NUSGreyhats/hackbadge/art/hackbash.png

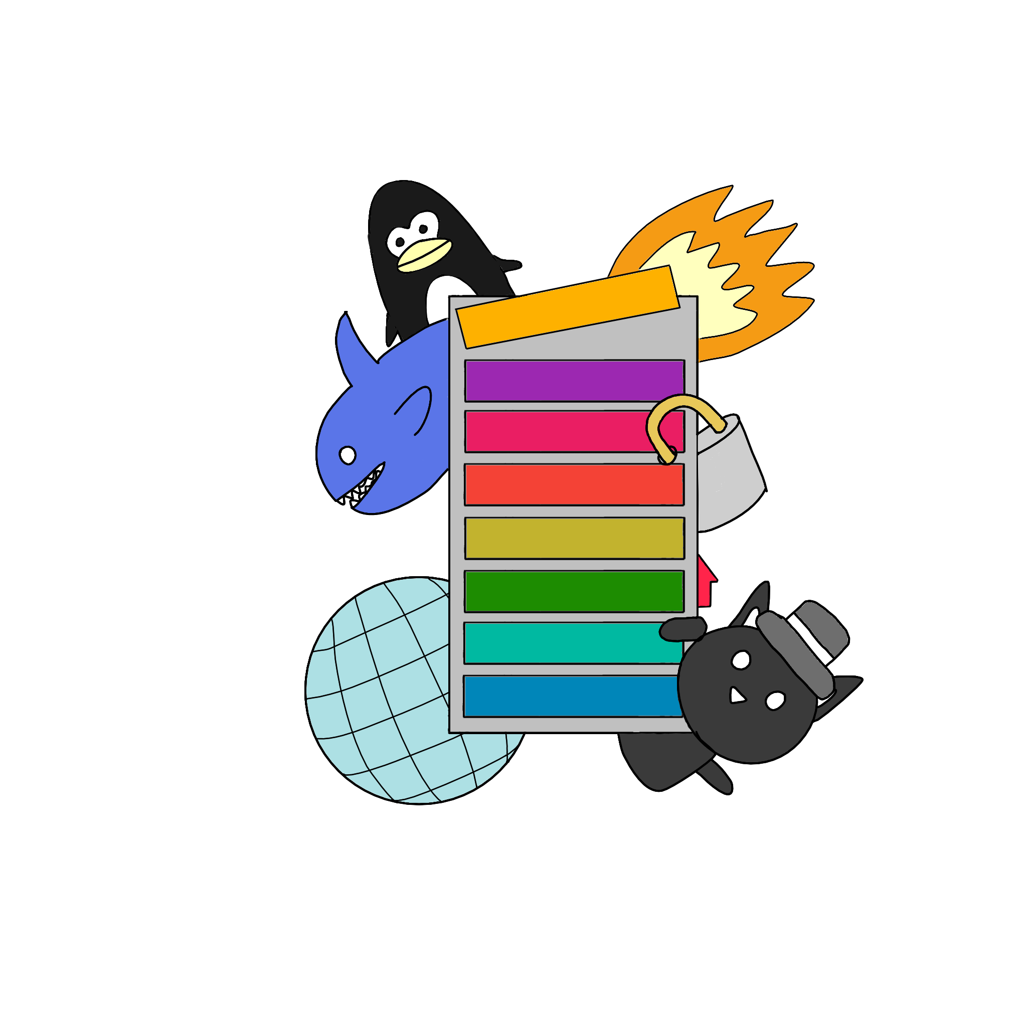
art/hackbash.png
