NUSGreyhats/hackbadge/hackbash/fabrication files/BOM_hackbash_hackbash_2025-10-20.xlsx

No. | Quantity | Comment | Designator | Footprint | Value | Manufacturer Part | Manufacturer | Supplier Part | Supplier | Supplier Footprint
1 | 1 | CR2032弯脚电池片铜 3V | BT1 | BAT-SMD_CR2032-3V |  | CR2032弯脚电池片铜 3V | QIJEY | C70373 | LCSC | SMD
2 | 4 | 10uF | C1,C2,C3,C4 | C0805 | 10uF | CL21A106KAYNNNE | SAMSUNG(三星) | C15850 | LCSC | 0805
3 | 2 | F.0805.00006/P2-0805R1TS2-08T-002 | D2,D3 | LED0805-R-RD |  | F.0805.00006/P2-0805R1TS2-08T-002 | TUOZHAN(拓展光电) | C7496834 | LCSC | 0805
4 | 2 | XL-2012UBC-A | D4,D5 | LED-SMD_L2.0-W1.3-RD_XL-2012UGC-DS |  | XL-2012UBC-A | XINGLIGHT(成兴光) | C7371912 | LCSC | 0805
5 | 2 | F.0805.00004/P2-0805G2TS2-08T-002 | D6,D7 | LED0805-R-RD_GREEN |  | F.0805.00004/P2-0805G2TS2-08T-002 | TUOZHAN(拓展光电) | C7496832 | LCSC | 0805
6 | 2 | XL-2012UYC | D8,D9 | LED0805-RD_YELLOW |  | XL-2012UYC | XINGLIGHT(成兴光) | C965814 | LCSC | 0805
7 | 2 | F.0805.00034/P2-0805W7YS2-08T-006 | D10,D11 | LED0805-RD |  | F.0805.00034/P2-0805W7YS2-08T-006 | TUOZHAN(拓展光电) | C7496841 | LCSC | 0805
8 | 2 | XL-2012UOC | D12,D13 | LED0805-RD_ORANGE |  | XL-2012UOC | XINGLIGHT(成兴光) | C965813 | LCSC | 0805
9 | 1 | Mechanical_MountingHole | H1 | MountingHole:MountingHole_3.2mm_M3_DIN965_Pad | MountingHole
10 | 1 | WAFER-XH254WZ-3AL | J1 | CONN-TH_WAFER-XH254WZ-3A |  | WAFER-XH254WZ-3AL | HANBO(汉博) | C22751805 | LCSC | 弯插,P=2.54mm
11 | 1 | MIC-4013-G-G00 | MIC1 | MIC-SMD_BD4.0-4013_SMDA |  | MIC-4013-G-G00 | SAMZO(三佐) | C42371093 | LCSC | SMD,D=4mm
12 | 5 | 5.1kΩ | R1,R16,R17,R18,R19 | R0805 | 5.1kΩ | 0805W8F5101T5E | UNI-ROYAL(厚声) | C27834 | LCSC | 0805
13 | 1 | 2.2kΩ | R2 | R0805 | 2.2kΩ | 0805W8F2201T5E | UNI-ROYAL(厚声) | C17520 | LCSC | 0805
14 | 1 | 1.5kΩ | R3 | R0805 | 1.5kΩ | 0805W8F1501T5E | UNI-ROYAL(厚声) | C4310 | LCSC | 0805
15 | 4 | 47Ω | R4,R5,R12,R13 | R0805 | 47Ω | 0805W8F470JT5E | UNI-ROYAL(厚声) | C17714 | LCSC | 0805
16 | 2 | 150Ω | R6,R7 | R0805 | 150Ω | 0805W8F1500T5E | UNI-ROYAL(厚声) | C17471 | LCSC | 0805
17 | 6 | 100Ω | R8,R9,R10,R11,R14,R15 | R0805 | 100Ω | 0805W8F1000T5E | UNI-ROYAL(厚声) | C17408 | LCSC | 0805
18 | 3 | HX TS3315A-H 250gf | SW1,SW2,SW3 | SW-SMD_4P-L3.4-W3.4-P2.00-LS4.0_TS3315A160GF |  | HX TS3315A-H 250gf | hanxia(韩下) | C5143623 | LCSC | SMD
19 | 1 | MST-22D18G4-WT | SW4 | SW-SMD_MST-22D18G4-WT |  | MST-22D18G4-WT | SHOU HAN(首韩) | C7507448 | LCSC | SMD
20 | 1 | CH32V003A4M6 | U1 | SOIC-16_L9.9-W3.9-P1.27-LS6.0-BL |  | CH32V003A4M6 | WCH(南京沁恒) | C5346357 | LCSC | SOP-16
21 | 1 | XC6206P332MR-G | U2 | SOT-23-3_L2.9-W1.6-P1.90-LS2.8-BR |  | XC6206P332MR-G | TOREX(特瑞仕) | C5446 | LCSC | SOT-23-3L
22 | 1 | TYPE-C 16PIN 2MD(073) | USB2 | USB-C-SMD_TYPE-C-6PIN-2MD-073 |  | TYPE-C 16PIN 2MD(073) | SHOU HAN(首韩) | C2765186 | LCSC | SMD
