NUSGreyhats/hackbadge/(list of files, drawings)

Other design files:
hackbash.eprj
