NUSGreyhats/hackbadge/hackbash/hackbash.kicad_pcb

## KiCad design hackbash/hackbash.kicad_pcb (2025-10-17)

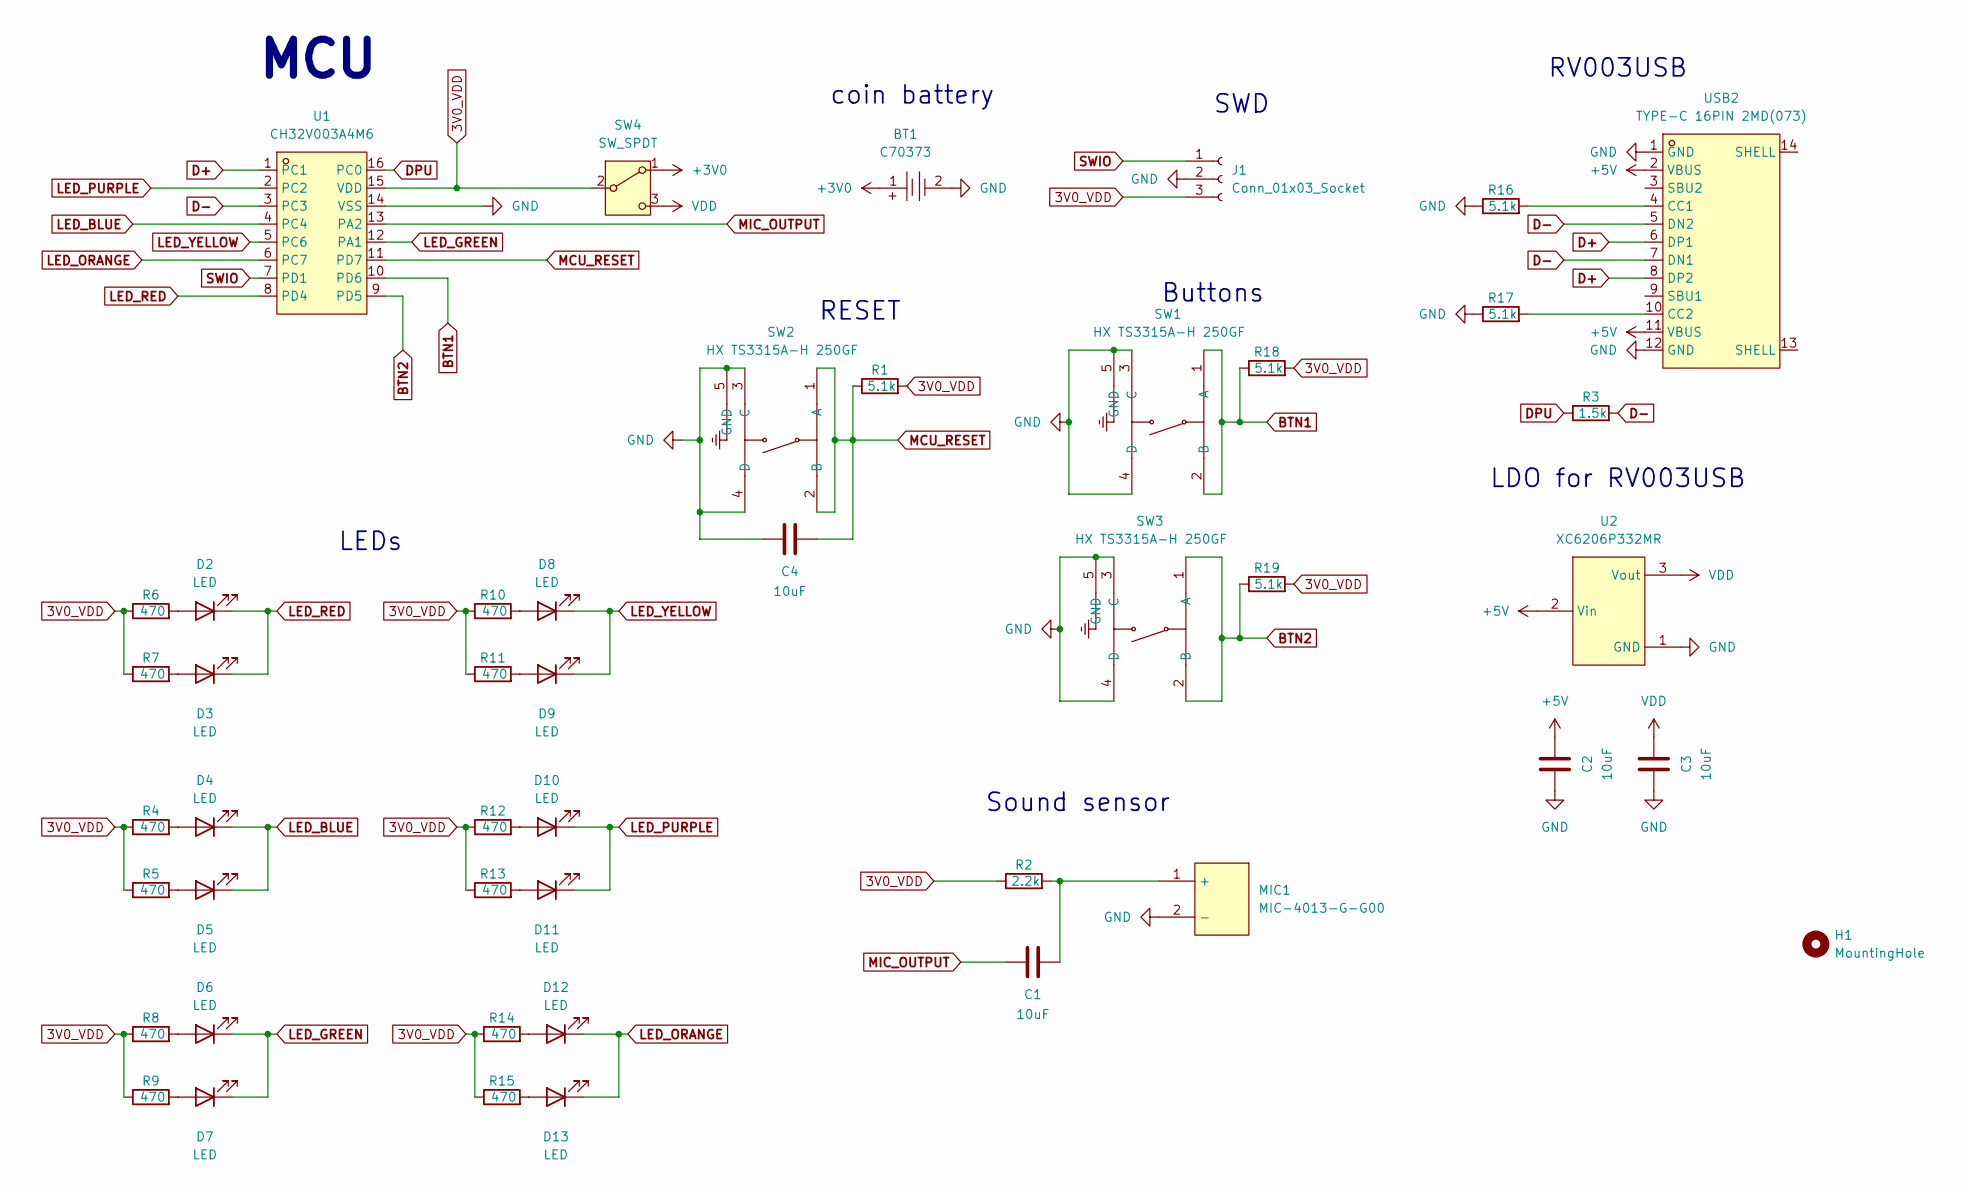
[picture p2: schematic hackbash.kicad_sch]

Parts:
BT1: C70373; BAT-SMD_CR2032-3V; LCSC Part C70373
C1, C2, C3, C4: 10uF; C_0805_2012Metric_Pad1.18x1.45mm_HandSolder
D2, D3, D4, D5, D6, D7, D8, D9, D10, D11, D12, D13: LED; LED_0805_2012Metric_Pad1.15x1.40mm_HandSolder
H1: MountingHole; MountingHole_3.2mm_M3_DIN965_Pad
J1: Conn_01x03_Socket; PinSocket_1x03_P2.54mm_Vertical_SMD_Pin1Right
MIC1: MIC-4013-G-G00; MIC-SMD_BD4.0-4013_SMDA; LCSC Part C42371093
R1, R16, R17, R18, R19: 5.1k; R_0805_2012Metric_Pad1.20x1.40mm_HandSolder
R2: 2.2k; R_0805_2012Metric_Pad1.20x1.40mm_HandSolder
R3: 1.5k; R_0805_2012Metric_Pad1.20x1.40mm_HandSolder
R4, R5, R6, R7, R8, R9, R10, R11, R12, R13, R14, R15: 470; R_0805_2012Metric_Pad1.20x1.40mm_HandSolder
SW1, SW2, SW3: HX TS3315A-H 250GF; SW-SMD_4P-L3.4-W3.4-P2.00-LS4.0_TS3315A160GF; LCSC Part C5143623
SW4: SW_SPDT; SW-SMD_SK-01A-H1.5
U1: CH32V003A4M6; SOIC-16_L9.9-W3.9-P1.27-LS6.0-BL; LCSC Part C5346357
U2: XC6206P332MR; SOT-23-3_L2.9-W1.6-P1.90-LS2.8-BR; LCSC Part C5446
USB2: TYPE-C 16PIN 2MD(073); USB-C-SMD_TYPE-C-6PIN-2MD-073; LCSC Part C2765186

Connections:
3V0_VDD: J1.3, R1.2, R2.1, R4.1, R5.1, R6.1, R7.1, R8.1, R9.1, R10.1, R11.1, R12.1, R13.1, R14.1, R15.1, R18.2, R19.2, SW4.2 (B), U1.15 (VDD)
+3V0: BT1.1, SW4.1 (A)
+5V: C2.2, U2.2 (Vin), USB2.2 (VBUS), USB2.11 (VBUS)
BTN1: R18.1, SW1.1 (A), SW1.2 (B), U1.10 (PD6)
BTN2: R19.1, SW3.1 (A), SW3.2 (B), U1.9 (PD5)
D+: U1.1 (PC1), USB2.6 (DP1), USB2.8 (DP2)
D-: R3.2, U1.3 (PC3), USB2.5 (DN2), USB2.7 (DN1)
DPU: R3.1, U1.16 (PC0)
GND: BT1.2, C2.1, C3.1, C4.1, J1.2, MIC1.2 (-), R16.1, R17.1, SW1.3 (C), SW1.4 (D), SW1.5 (GND), SW2.3 (C), SW2.4 (D), SW2.5 (GND), SW3.3 (C), SW3.4 (D), SW3.5 (GND), U1.14 (VSS), U2.1 (GND), USB2.1 (GND), USB2.12 (GND); also elsewhere on the board
LED_BLUE: D4.1 (K), D5.1 (K), U1.4 (PC4)
LED_GREEN: D6.1 (K), D7.1 (K), U1.12 (PA1)
LED_ORANGE: D12.1 (K), D13.1 (K), U1.6 (PC7)
LED_PURPLE: D10.1 (K), D11.1 (K), U1.2 (PC2)
LED_RED: D2.1 (K), D3.1 (K), U1.8 (PD4)
LED_YELLOW: D8.1 (K), D9.1 (K), U1.5 (PC6)
MCU_RESET: C4.2, R1.1, SW2.1 (A), SW2.2 (B), U1.11 (PD7)
MIC_OUTPUT: C1.1, U1.13 (PA2)
unnamed: D2.2 (A), R6.2
unnamed: D3.2 (A), R7.2
unnamed: D4.2 (A), R4.2
unnamed: D5.2 (A), R5.2
unnamed: D6.2 (A), R8.2
unnamed: D7.2 (A), R9.2
unnamed: D8.2 (A), R10.2
unnamed: D9.2 (A), R11.2
unnamed: D10.2 (A), R12.2
unnamed: D11.2 (A), R13.2
unnamed: D12.2 (A), R14.2
unnamed: D13.2 (A), R15.2
unnamed 29: C1.2, MIC1.1 (+), R2.2; also elsewhere on the board
unnamed: R16.2, USB2.4 (CC1)
unnamed: R17.2, USB2.10 (CC2)
SWIO: J1.1, U1.7 (PD1)
VDD: C3.2, SW4.3 (C), U2.3 (Vout)

Notes on the sheet:
LDO for RV003USB
SWD
Sound sensor
LEDs
RV003USB
coin battery
MCU
RESET
Buttons

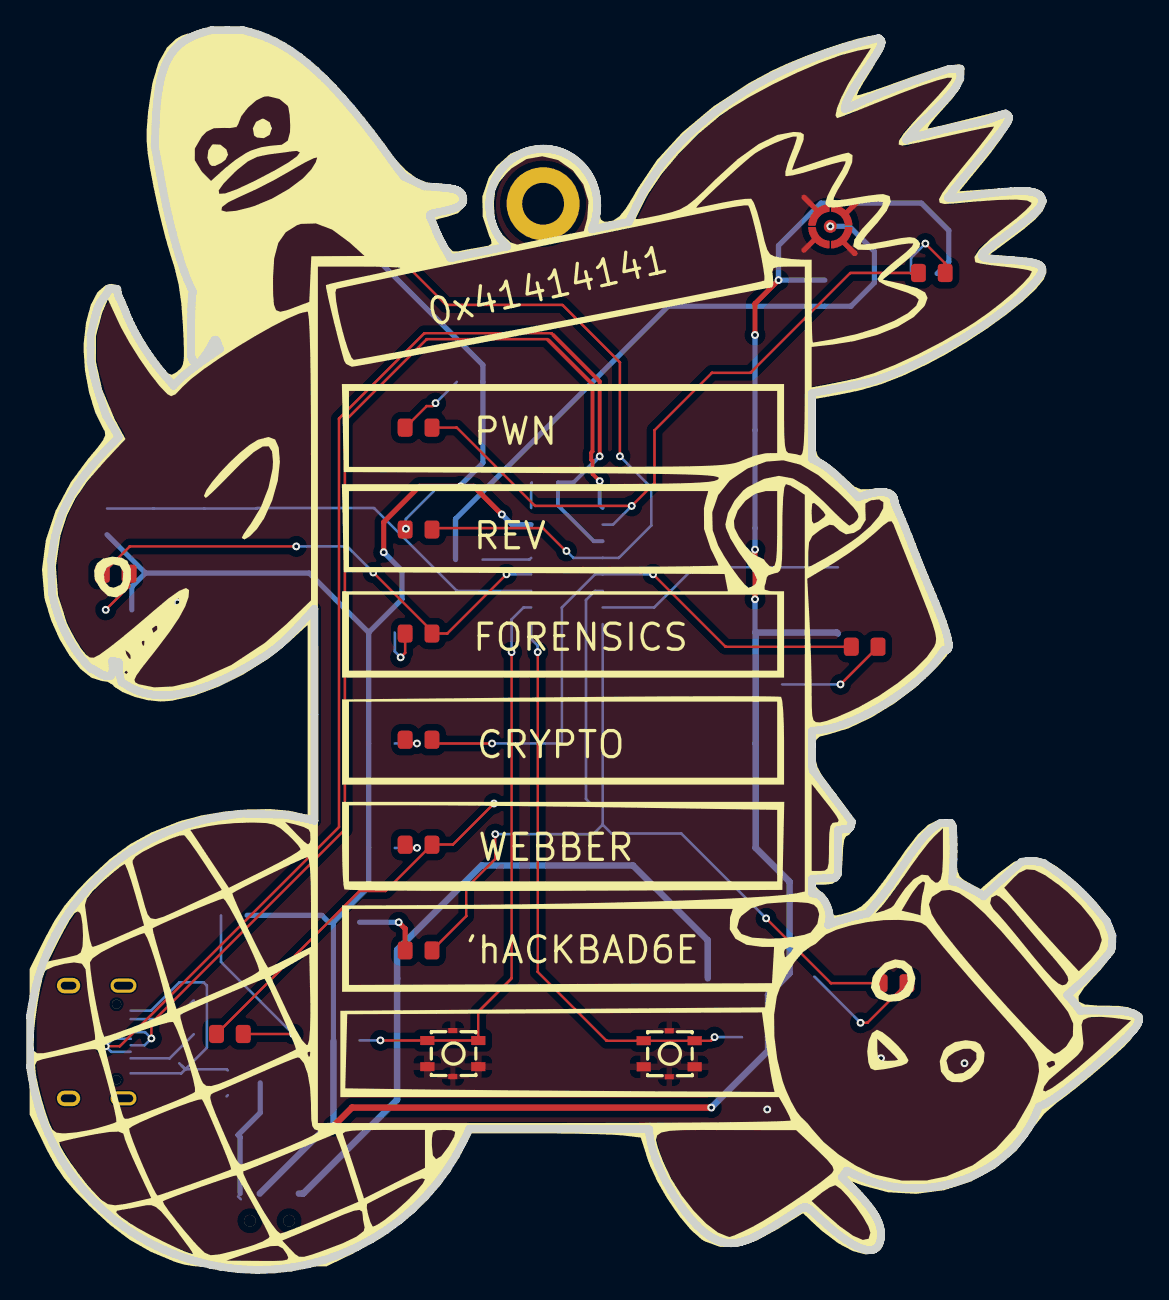
[picture p3: board hackbash.kicad_pcb from above]

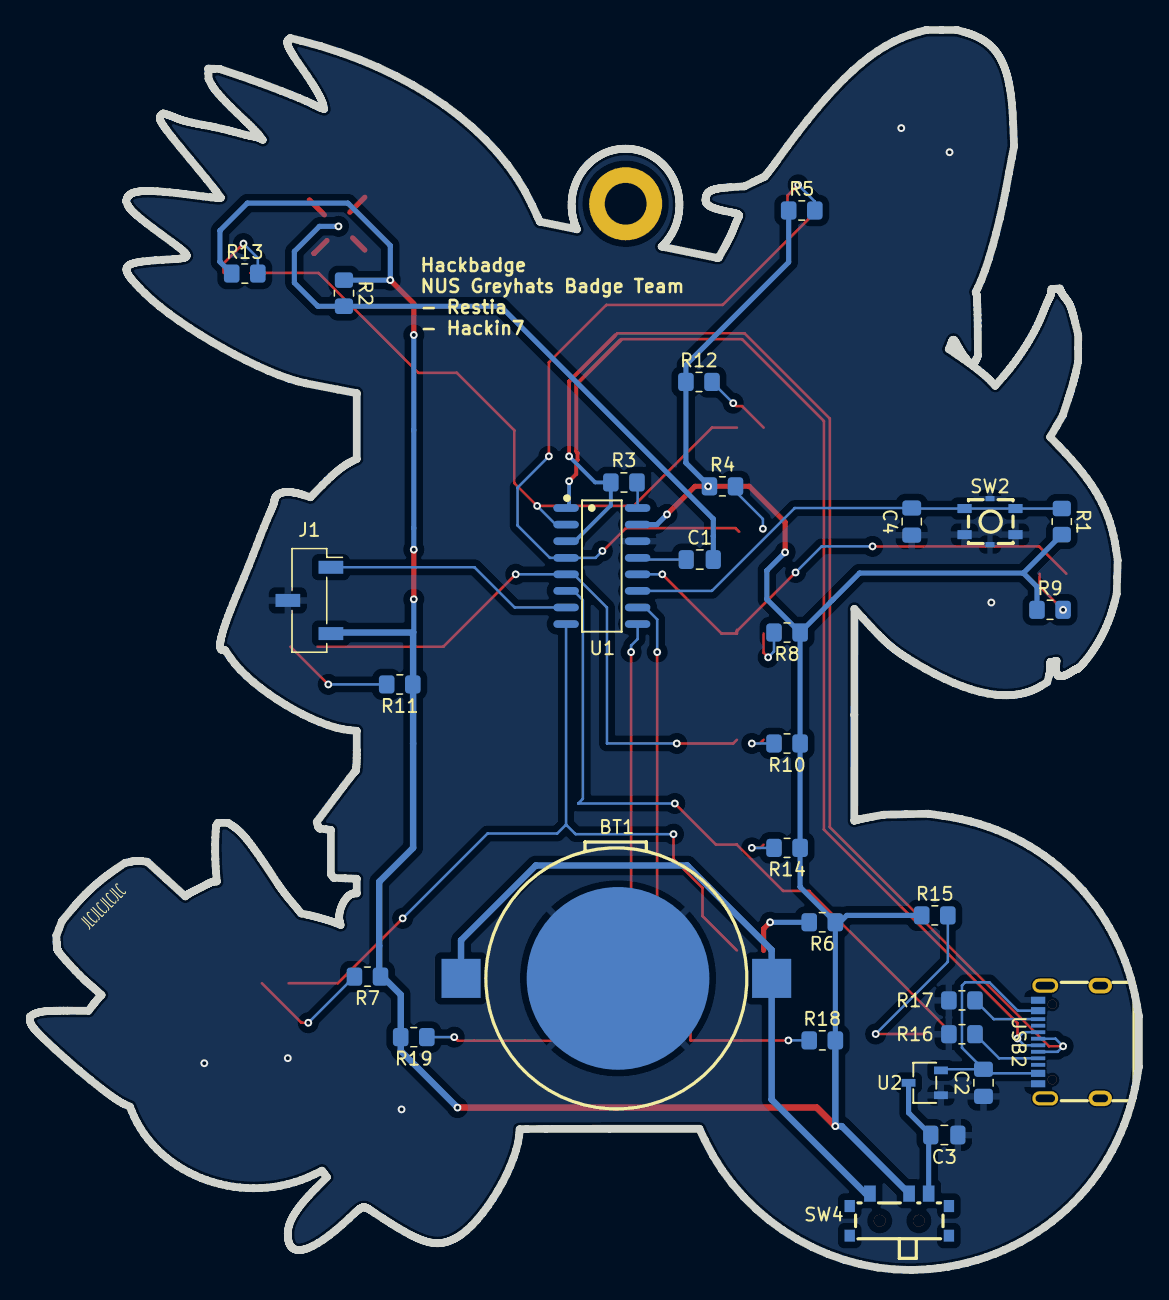
[picture p4: board hackbash.kicad_pcb from below]

Board: 2 copper layers, 85.0 x 95.0 mm, 46 parts (30 on the bottom side), 34 nets.

Other parts of the board:
MIC: MIC-4013-G-G00; MIC-SMD_BD4.0-4013_SMDA

Their connections:
GND: MIC.2 (-); also elsewhere on the board
unnamed 29: MIC.1 (+); also elsewhere on the board
