NUSGreyhats/hackbadge/code/main/led_gpio.h

#include "ch32fun.h"
#include "pinout.h"  

void gpioLedInit( void ) {
    // Configure LEDs as outputs
    funPinMode(LED_PURPLE, GPIO_Speed_10MHz | GPIO_CNF_OUT_PP);
    funPinMode(LED_RED,    GPIO_Speed_10MHz | GPIO_CNF_OUT_PP);
    funPinMode(LED_ORANGE, GPIO_Speed_10MHz | GPIO_CNF_OUT_PP);
    funPinMode(LED_YELLOW, GPIO_Speed_10MHz | GPIO_CNF_OUT_PP);
    funPinMode(LED_GREEN,  GPIO_Speed_10MHz | GPIO_CNF_OUT_PP);
    funPinMode(LED_BLUE,   GPIO_Speed_10MHz | GPIO_CNF_OUT_PP);
}

// LEDs are active LOW (GPIO LOW = LED ON)
#define LED_ON   FUN_LOW
#define LED_OFF  FUN_HIGH

// Turn off all LEDs (write HIGH since active-low)
void allLedsOff()
{
    funDigitalWrite(LED_PURPLE, LED_OFF);
    funDigitalWrite(LED_RED, LED_OFF);
    funDigitalWrite(LED_GREEN, LED_OFF);
    funDigitalWrite(LED_BLUE, LED_OFF);
    funDigitalWrite(LED_YELLOW, LED_OFF);
    funDigitalWrite(LED_ORANGE, LED_OFF);
}

// Software PWM for one pin
// brightness: 0..100
// duration_s: seconds (integer)
void lightUpLed(char color, uint8_t brightness, uint16_t duration_ms)
{
    int pin;

    if (color == 'P')           pin = LED_PURPLE;
    else if (color == 'B')   pin = LED_BLUE;
    else if (color == 'Y') pin = LED_YELLOW;
    else if (color == 'O') pin = LED_ORANGE;
    else if (color == 'R')    pin = LED_RED;
    else if (color == 'G')  pin = LED_GREEN;
    else return;

    // Turn off all LEDs first
    allLedsOff();

    if (brightness == 0) {
        return;
    }
    if (brightness >= 100) {
        funDigitalWrite(pin, LED_ON);  // Active LOW - write LOW to turn on
        Delay_Ms(duration_ms);
        funDigitalWrite(pin, LED_OFF);
        return;
    }

    // Software PWM parameters
    const uint8_t period_ms = 20;    // 20ms period (50Hz)
    const uint8_t slice_ms = 2;      // 2ms resolution
    const uint8_t slices = period_ms / slice_ms; // 10 slices
    uint8_t on_slices = (brightness * slices) / 100;

    // Run for duration_s seconds
    uint32_t iterations = duration_ms / period_ms;
    for (uint32_t it = 0; it < iterations; it++)
    {
        for (uint8_t s = 0; s < slices; s++)
        {
            if (s < on_slices) {
                funDigitalWrite(pin, LED_ON);  // Active LOW
            }
            else {
                funDigitalWrite(pin, LED_OFF);
            }
            Delay_Ms(slice_ms);
        }
    }
    funDigitalWrite(pin, LED_OFF);
}
