NUSGreyhats/hackbadge/(commit log)

2025-10-05 pcb design in kicad done
    [hackbash.kicad_pcb, hackbash.kicad_sch]
2025-10-15 chore: cleanup repo
    [hackbash.kicad_pcb, hackbash.kicad_sch]
2025-10-15 feat: art design
    [hackbash.kicad_pcb]
2025-10-17 touched up and converted to easyeda project
    [hackbash.eprj, hackbash.kicad_pcb]
2025-10-20 final work sent for fabrication
    [BOM_hackbash_hackbash_2025-10-20.xlsx, PickAndPlace_hackbash_2025-10-20.xlsx, Sample-BOM_JLCSMT.xlsx, hackbash.eprj, hackbash_BOM.csv, hackbash_BOM.xlsx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]
2025-12-24 feat: simple led cycle
2025-12-24 feat: buttons blinky
2025-12-24 feat: blue led pwm
2025-12-24 feat: timer pwm red led also
2025-12-24 feat: purple LED PWM
2025-12-24 feat: Timer PWM stuff allows all pins to be on
2025-12-24 feat: cycle through LEDs
2025-12-25 feat: somewhat functional pwm
2025-12-25 feat: functioning timer_pwm code to reduce LED brightness?
2025-12-25 chore: pwm some refactoring
2025-12-25 feat: enable for timer 2
2025-12-25 feat: pwm leds audio volume
2025-12-25 feat: breathing led pwm
2025-12-25 feat: button interrupts poc
2025-12-25 feat: 2 button interrupts
2025-12-25 feat: button interrupts header file
2025-12-25 change main mode to button interrupts
2025-12-25 feat: fix ctf mode button
    [main.c, mode_ctf.h]
2025-12-28 fix: comparison btwn ptr and int
    [mode_ctf.h]
2025-12-28 fix: add missing return
    [mode_ctf.h]
2025-12-29 fix: correctly use placeholder vals for buffer
    [mode_ctf.h]
2026-01-20 fix: led not working bug on mode switching of leds
    [main.c, mode_blinky.h, mode_mic.h]
2026-01-20 Fix fade pulsing all leds at max brightness in every cycle
    [mode_blinky.h]
2026-01-22 fix: fade pulsing all leds at max brightness in every cycle
    [mode_blinky.h]
2026-01-22 refactor: rework mic to properly sample and show correct sound level
    [mode_mic.h]
2026-01-22 feat: led gatekeeping
2026-01-22 feat: led sparkle mode - mvp 2
2026-01-23 feat: move debug printing to a own function
2026-01-23 refactor: disable all debug printing in main
2026-01-23 refactor: replace string references with cha
    [led_gpio.h, main.c, mode_blinky.h]
